androidthings/experiment-expression-flower/images/ch4_5_tighten_all_cables.png

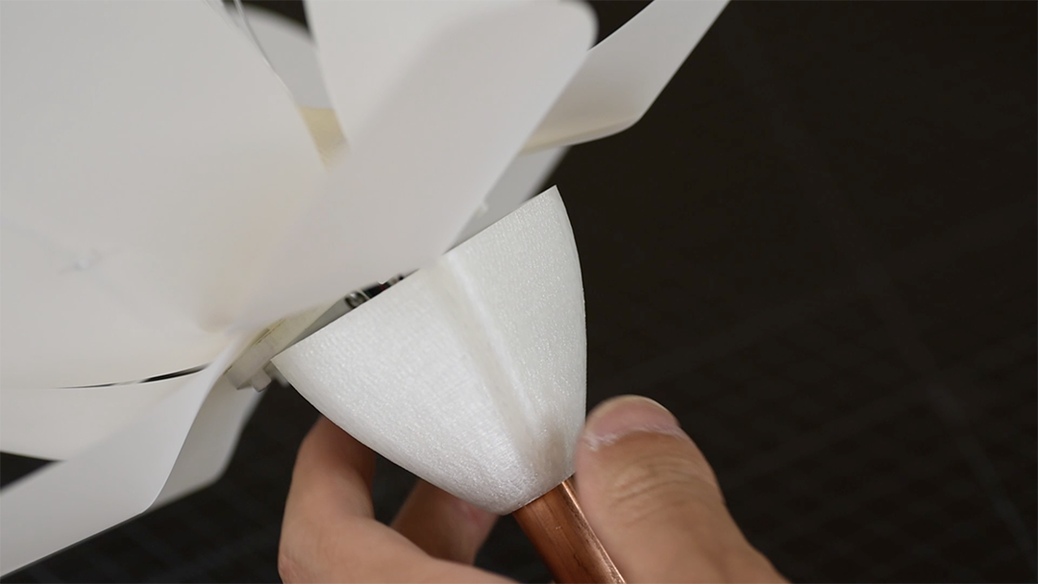
images/ch4_5_tighten_all_cables.png
