androidthings/experiment-expression-flower/images/ch4_6_tighten_up_cables.png

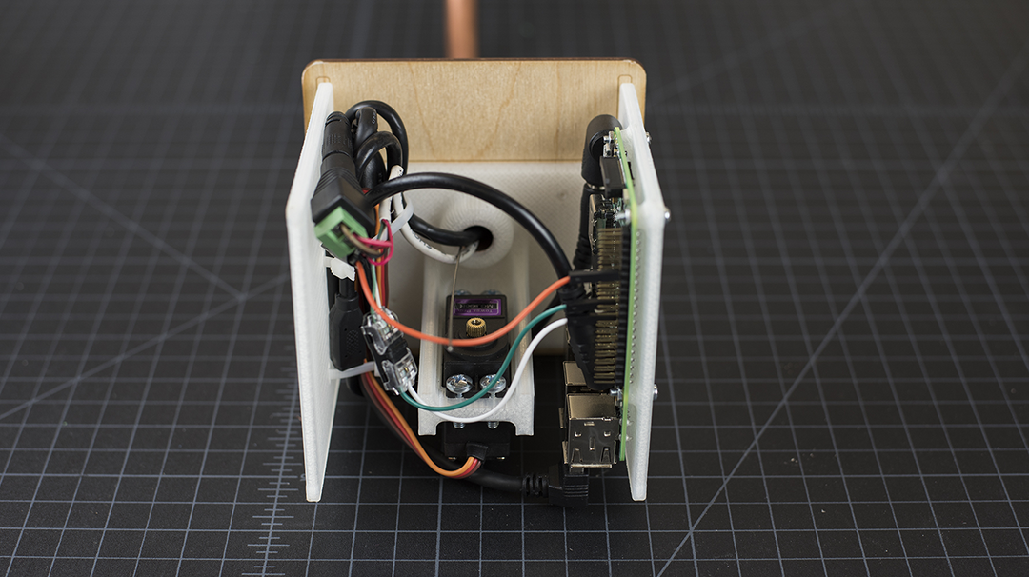
images/ch4_6_tighten_up_cables.png
