androidthings/experiment-expression-flower/fabrication/3D_Printing_Flower_Head_WireHookAssembly.stl

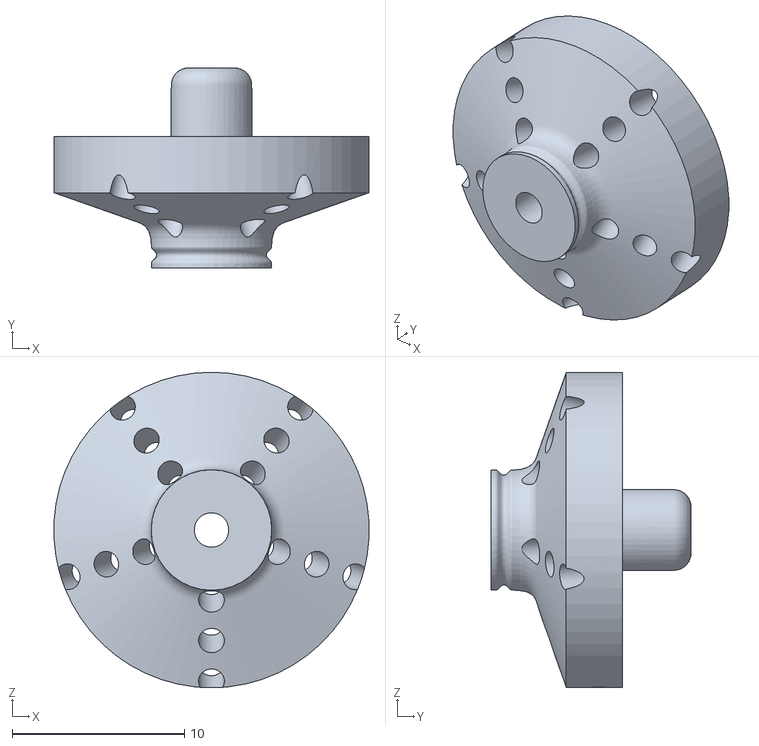
[picture p35: CAD file, 2018-08-09]
fabrication/3D_Printing_Flower_Head_WireHookAssembly.stl
18.3 x 11.6 x 18.3
