androidthings/experiment-expression-flower/fabrication/3D_Printing_Flower_Head_Retainer_Ring.stl

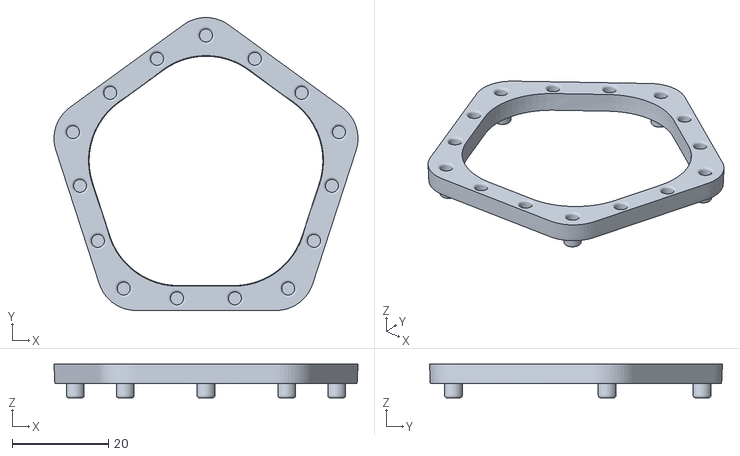
[picture p36: CAD file, 2018-08-09]
fabrication/3D_Printing_Flower_Head_Retainer_Ring.stl
63.0 x 60.7 x 7.00
