androidthings/experiment-expression-flower/fabrication/3D_Printing_Flower_Head_Bottom_Cap.stl

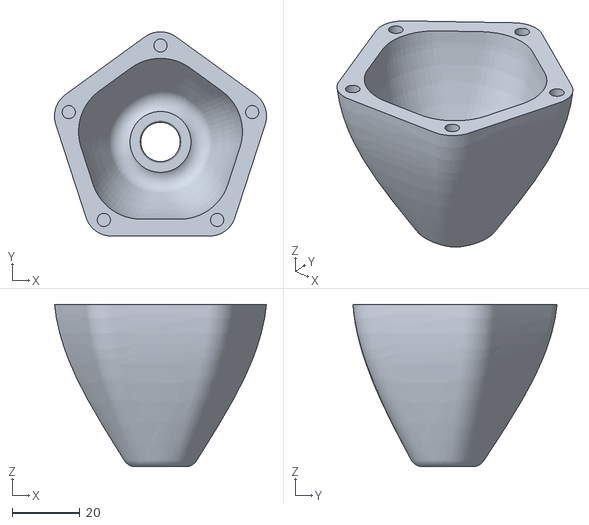
[picture p37: CAD file, 2018-08-09]
fabrication/3D_Printing_Flower_Head_Bottom_Cap.stl
62.7 x 60.4 x 48.0
