androidthings/experiment-expression-flower/fabrication/Laser_Cutting_Petals.dxf

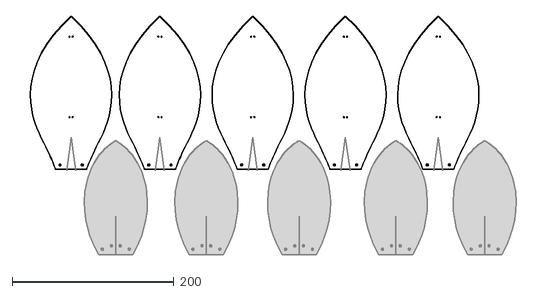
[picture p38: CAD file, 2018-08-09]
fabrication/Laser_Cutting_Petals.dxf
622.7 x 295.1
