androidthings/experiment-expression-flower/fabrication/3D_Printing_Flower_Head_WireHookRing.stl

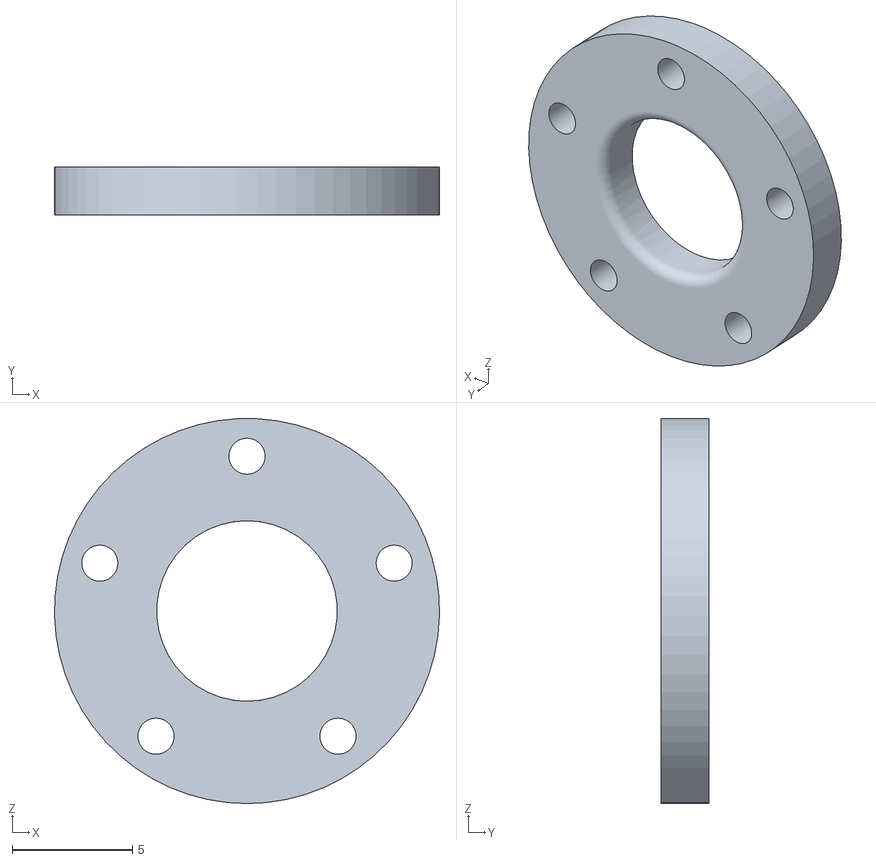
[picture p39: CAD file, 2018-08-09]
fabrication/3D_Printing_Flower_Head_WireHookRing.stl
16.0 x 2.00 x 16.0
