androidthings/experiment-expression-flower/fabrication/3D_Printing_Flower_Head_LED_Cam_Insert.stl

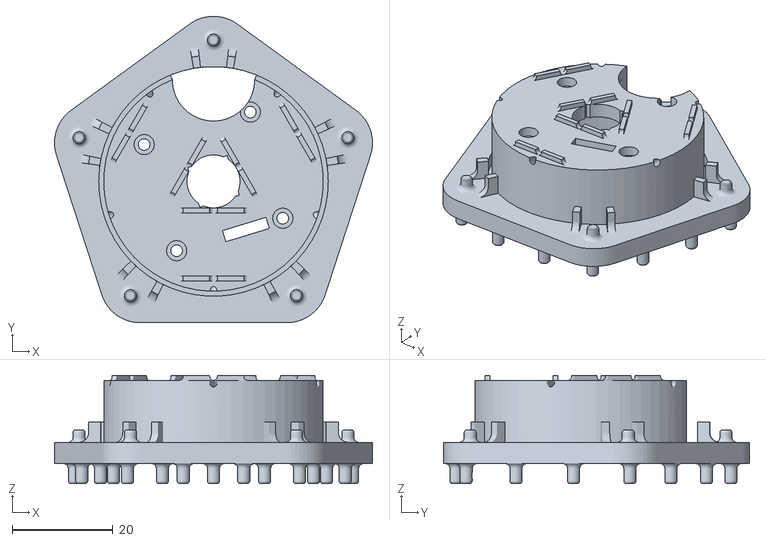
[picture p40: CAD file, 2018-08-09]
fabrication/3D_Printing_Flower_Head_LED_Cam_Insert.stl
63.0 x 60.7 x 21.5
