androidthings/experiment-expression-flower/fabrication/3D_Printing_Flower_Base.stl

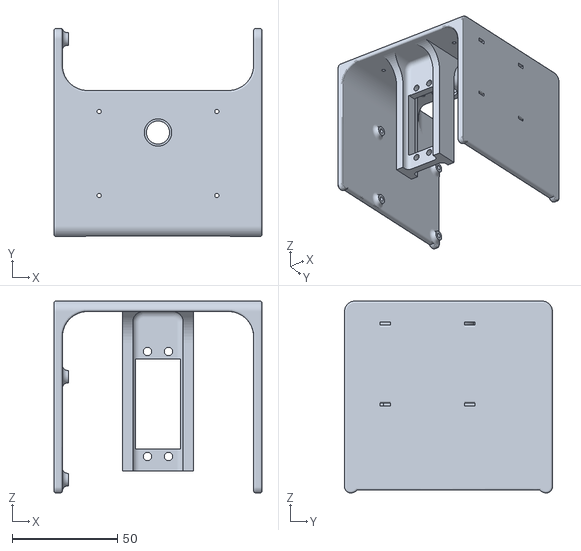
[picture p41: CAD file, 2018-08-09]
fabrication/3D_Printing_Flower_Base.stl
99.0 x 99.0 x 91.4
