androidthings/experiment-expression-flower/fabrication/3D_Printing_Flower_Head_Top_Cap.stl

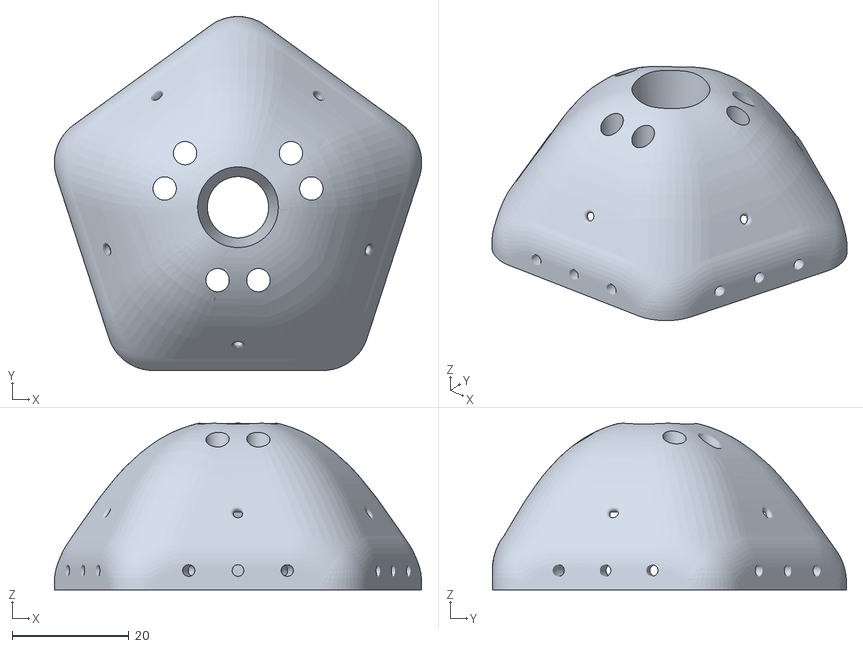
[picture p42: CAD file, 2018-08-09]
fabrication/3D_Printing_Flower_Head_Top_Cap.stl
63.0 x 60.7 x 28.6
