androidthings/experiment-expression-flower/fabrication/3D_Printing_Flower_Base_Pulley.stl

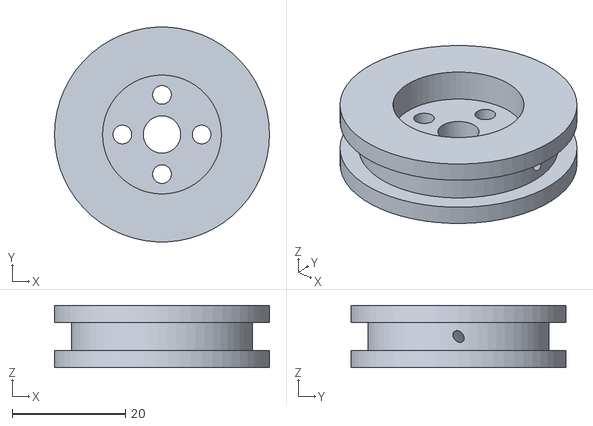
[picture p43: CAD file, 2018-08-09]
fabrication/3D_Printing_Flower_Base_Pulley.stl
38.0 x 37.9 x 11.0
