androidthings/experiment-expression-flower/(list of files, cad)

Other CAD files:
fabrication/Laser_Cutting_Base_Cap.dxf
